temoto/vender/internal/ui/interface-text-display-ru.md

# Интерфейс клиента

Далее так описан текст на двухстрочном дисплее:
1 первая строка
2 вторая строка

### @ожидание
1 настраиваемая бегущая строка
2 (Только монеты) | (Грею воду)
- основное состояние после успешной загрузки
- key сливки/сахар -> @сливки-сахар
- key 0-9 -> @меню код напитка +key
- вставили деньги -> @меню кредит +сумма

### @меню
1 Кредит:     xxx.xx|
2 Код напитка:   xxx|
- key esc (непустой код) -> стереть последний символ
- key esc (пустой код, кредит=0) -> @ожидание
- key ok (пустой код) -> 1 ошибка 2 нет напитка
- key ok (неизвестный код) -> 1 временно 2 нет напитка
- key ok (мало денег) -> 1 Вставьте монеты(/купюры) 2 Цена xxx.xx
- key ok (достаточно денег) -> @готовится

### @сливки-сахар
1 Сливки/Сахар
2 '-' шкала '+'
- доступно всегда
- по-умолчанию 4

### @готовится
1 Готовится напиток. Подождите.
2 progress bar
- успех -> @приготовил
- ошибка -> @ошибка

### @приготовил
1 Ваш напиток ожидание
2 Спасибо
- timeout -> @ожидание

### @ошибка
1 Автомат не работает
2 (устройство) (код ошибки)
- до выключения

### @кончились-стаканы
1 Загружаются стаканы
2 Пожалуйста, подождите
- -> @ожидание / @ошибка
