temoto/vender/(threads)

Thread 1 (2018-09-10):

Hardware information

mhaqs, 2018-09-10:
I stumbled upon this repository in search of open source firmwares for vending machines. I've skimemd through the source code a bit but cannot put a finger on what hardware this firmware is for. It'd be a good addition to the repo, to have a supported hardware profile or readme that explains, how to use this.

endes123321, 2018-09-10:
Its all made in go, so I think is for a Raspberry pi or similar.

temoto, 2018-09-10:
@mhaqs we run on RaspberryPi. It could be virtually any machine supported by Go. Readme is a must, of course. I understand it's a bad reason, but didn't put much effort into documentation because it's early development stage. Hold on, I am committed to make this work publicly useful.

Dependencies:
- Linux 4.9+
- Go supported arch
- UART for MDB. We tried separate ATMega device for 9bit serial encoding, but I failed to make it reliable. With Linux kernel 4.9+ it's possible to do 9bit serial using termios.
- 4 GPIO pins for MT16S2R like display driver (as of 2018-09 in development)
- TWI (I2C) for a numpad keyboard

mhaqs, 2018-09-11:
@temoto It's good to know the project's active and you're maintaining it. May be this project could help: http://eliverse.com/wiki/index.php?title=Programming_Vendiverse_VMC_Board?

I know it differs in many respects but I've been meaning to work on a generic firmware myself. I'll go through the repo and see if I can contribute something. This is one of the primary reasons why I wanted to know the project's goal or architecture.

temoto, 2018-09-11:
@mhaqs do you know how to see their sources? I couldn't find it with a quick look.

mhaqs, 2018-09-11:
I was able to scrape the following files:

http://eliverse.com/downloads/vendiverse/software/ENV/ENV.ino
http://eliverse.com/downloads/vendiverse/software/MDB/MDB_STABLE.ino

The last one found here: http://eliverse.com/wiki/index.php?title=Vendiverse_MDB_Module

temoto, 2018-09-11:
Thank you.

mhaqs, 2018-09-17:
Just so if it helps you @temoto , I looked into the armbian image on the vendiverse website, and it has the python source code:

https://drive.google.com/file/d/1Heywm-dtGibz40IBfigaMmpYiOhnLkyE/view

temoto, 2018-09-17:
Thank you. What was interesting to me is references to hardware they used, NFC reader MFRC522 in particular.

mhaqs, 2018-09-20:
I think the differences come from using I2C as preferred communication method with the other hardware. The choice of RFC522 might also be because of that.

azonicdh2000, 2018-11-16:
@mhaqs Have you tried making the Vendiverse vmc board?

mhaqs, 2018-11-22:
@azonicdh2000 I haven't. I have instead been working on a pi3/udoo equivalent with arduinos instead. It was a bit hard to copy everything vendiverse offers.

This is why I like the approach vender takes. The vmc software should be able to cope with the hardware at offer. However, a configuration of the hardware would be great to start with. I've seen some hardware schematics posted on this repo by @AlexTransit. I will contribute some hardware and software knowledge as well in the near future.

What are you looking for @azonicdh2000? We can move the discussion else where as well.

temoto, 2018-11-22:
The key takeaway from Alex schematics is UART-MDB converter. It is optoisolated logic level 3.3-5V switch with level inverter on one line, as per MDB spec. It works, use it. Huge thanks to this person http://blog.bouni.de/2012/the-mdb-protocol-part-1.html

As of 2018-11-22 vender has (maybe alpha-beta) support for MDB coin changer and bill validator. Right now we work on drink preparing devices, and overall "kitchen" codebase, like recipes. Next step is user interface after which we'll have something to show and talk about.

azonicdh2000, 2018-11-23:
@mhaqs I’m trying to create the Vendiverse vmc board. So which part of the vendiverse was a bit hard to copy? Was it the main vmc board or tray board?

Yes maybe we should move to another discussion for vendiverse.

But I will try to look at vender.

mhaqs, 2019-02-03:
The vendiverse website is now down, but I've hosted the contents here: https://github.com/mhaqs/vendiverse. You may move this discussion over there as well.

The vendiverse project does not talk about the motor control matrix. So, to answer your question, and to help with this project, I found this:

https://github.com/CCHS-Melbourne/vend-matrix

It shows, how you can use continuous motors in a matrix and to sense a low current to finish a vend. cc @AlexTransit , if that helps.

mr-darker, 2019-02-06:
@temoto Hey I just found your project!  I'm also making open source vending software, mine is just focused on the MDB protocol specifically.  Do you have any interest in merging projects or anything like that?

My project is currently aimed to run on an ESP32 development board, but can be modified to work on most other hardware.  The end-goal is to have it run as a module on a linux operating system (once finished) as a module, so sticking as closely to C code as possible is a requirement for mine.

Anyways, if it's of interest, let me know, because that'd be pretty cool.

mr-darker, 2019-02-06:
As in it'd be cool to have some sorta help, but also cool if no help was had, and someone found it useful (it's not currently operational, but will be soon).

temoto, 2019-02-06:
@mr-darker hello mate. We just finished MDB translator device code two days ago https://github.com/temoto/vender/tree/05de26478b9932c53c0d676d7333c4d4d9286967/hardware/mega-firmware It's for ATMega328 and TWI(i2c) interface to master board (raspberrypi/orangepi in our case) but I can see how ESP family would be useful with their communication options.

I'm interested in any open vending software/hardware effort. We can start by creating Github organisation and some communication channel (not sure what is popular these days). Code merging is a good idea, let's talk details in a separate topic.

What kind of help you need?

Are you developing a vending machine?

mr-darker, 2019-02-06:
I made a [separate forum for this topic](https://github.com/mr-darker/MDB-C/issues/14).  I don't really have a communication preference.

smashah, 2019-03-11:
Hey there,

Just wonder what everyone thinks of this bit of kit:

https://www.aliexpress.com/item/Raspberry-pi-to-vending-machine-MDB-cashless-interface-adapter-board-with-housing-working-with-bill-acceptor/32883995334.html

They haven't shared any library or code with me yet. Will this repo work with this hardware?

temoto, 2019-03-12:
@smashah hello.

> Will vender work with this MDB / RS-232 adapter hardware?

Not right now. By design vender is ready for another MDB adapter. I will happily help to write required code.

I think 95$ for a simple PCB is too much. We have made custom MDB / I2C adapter exactly because alternatives have unreasonable prices. Our adapter is less than 3$ in parts, both schematic and firmware is open source here. If you are comfortable with soldering, I suggest make our adapter. I can make and send you one.

temoto, 2019-07-19:
For anyone interested, using this as public announcement channel.

Current project state is "one issue from public installation". Ingredient state is lost on power off.

Now is good time to begin integration with other hardware. Please contact me if you want to run this VMC. temotor@gmail.com

mhaqs, 2019-07-22:
@temoto I've been following this project for a while. I'd like to set up the VMC and help the project while doing so as well. I've a Raspberry Pi B+ and an Arduino Uno R3. Some other hardware that I can procure as well.

I was wondering about a plan on how to go about running the project on said hardware and have the bare minimum of MDB device and a motor control array (maybe).

shirerre, 2022-04-21:
I'm interested in this project or at least in someone helping me to develop something similar. I need a vending controller that utilize mdb can accept coins and dollars. Make change. And basically activates a relay upon correct change being presented and the relay closes when a sensor/switch is tripped. I'm trying to replicate the board utilized by the BillMate 2 attached to the old national 222 cigarette machines.

temoto, 2022-04-22:
@shirerre

> I'm interested in this project or at least in someone helping me to develop something similar. I need a vending controller that utilize mdb can accept coins and dollars. Make change. And basically activates a relay upon correct change being presented and the relay closes when a sensor/switch is tripped. I'm trying to replicate the board utilized by the BillMate 2 attached to the old national 222 cigarette machines.

If your task is really that simple to activate relay without complex scenario, telemetry, etc, probably your best option is to build atmega328p powered MDB converted and put relay activation logic directly into it. See files in hardware/schematic and hardware/mega-firmware accordingly.

This board successfully worked with ICT and JCM money hardware. Beware, it is sensitive to power noise, we didn't have enough electronic expertise to make proper filter.

WallK, 2025-04-09:
Hello! I was looking around for a way to implement optical sensor into my machine
It has the input and can, theoretically, make a refund in vend didn't happen, but only on Executive protocol, not on MDB devices (if I understood the manual correctly)
Do you think it's possible to build some kind of a MitM device that will check if optical sensor was triggered and communicate with MDB payment device? Without upsetting everything else, I mean
Or should I try to change the controller to have it all integrated?
Thanks!

temoto, 2025-04-09:
Hello.

We never worked with executive protocol.
Depending on exact coin device  you may be able to trigger refund
externally, read it's manual.

Another bad solution is half-master optical checker that will issue coin
disperse commands on stuck state. Basically ATM function. It is hacker
prone.

Central controller like in vender is definitely best option but more work.

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

WallK, 2025-04-09:
@temoto thank you for the reply
I don't have Executive devices, I know about that only from the manual

I don't have a coin dispenser too, it's all cashless. So I really need to tell POS terminal to release the sum, basically
Basically hold for vend try, charge on success, release on timeout, something like this

So is vender project alive?

temoto, 2025-04-09:
Cashless is whole different world. You have hacker safe escrow, use it if
you can.

Vender project works in real devices but Alex does development in his fork
here https://github.com/AlexTransit/vender

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

WallK, 2025-04-09:
I still need to implement the logic somewhere to instruct the POS thingy

Thanks!

AlexTransit, 2025-09-20:
> **Question:** Do you think your project would allow me to use the CC6100, which uses MDB, to communicate with a simple DIY board to achieve this?

if you do not use Bill Validator, then you can use this project.
But if you need to give back more than 127, then get the problem.

Or you can use another project.
Here is the issuance of each coin under control. And you can choose different strategies how to give out.
https://github.com/AlexTransit/vender

Adrofex, 2025-09-20:
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

Thanks so much for the quick reply!

I won't use any Bill Validator. Just coins. The most anyone should enter into the machine is 100 coins for a 100thb purchase (100x1thb coins) but I doubt anyone would take the time to do that. Most likely somewhere between 10 to 20 coins (10thb/5thb coins).

I'll give it a try and check out the other project. I'll see if I can give a link when it's done (and working, I hope!) to show it's implementation.

Thanks again!

temoto, 2025-09-20:
@Adrofex wa-di! As you can see by last commit date, this original version of vender is stalled, but @AlexTransit  continues development in his fork.

In any case vender is not super novice-friendly, for success you have to read go code. It is quite easy to add support for *any* device that works in MDB slave mode. Coin device as master (kiosk mode) is not supported here.

Your plan makes sense, it is easy to configure relatively complex scenarios via built-in script system.

Thread 2 (2019-07-22):

second hardware configuration

temoto, 2019-07-22:
> @temoto I've been following this project for a while. I'd like to set up the VMC and help the project while doing so as well. I've a Raspberry Pi B+ and an Arduino Uno R3. Some other hardware that I can procure as well.

> I was wondering about a plan on how to go about running the project on said hardware and have the bare minimum of MDB device and a motor control array (maybe).

_Originally posted by @mhaqs in https://github.com/temoto/vender/issues/1#issuecomment-513727955_

temoto, 2019-07-22:
For a plan, please:
- describe in text an end result you like to see
- list MDB devices
- specifically what motor control array, how to operate it? Datasheet?

mhaqs, 2019-07-23:
@temoto Thanks for creating a separate issues for this. I think it's better this way. I have sent you an email with my _supposed_ motor control array setup/schematic. As an end result (even if it's creating a vending machine), I'd like Vender to be able to help with the basic of operations:

- Help and control MDB devices (Cash, Coin like ICT and Cashless like Nayax)
- The MDB devices can be in master/slave set up but I'm sure that's not an issue for now.
- I've shared my humble design of a motor control array with you over email. See if it's valid at all to work with Vender.
- My design included Raspberry Pi and Arduinos for the MVP. The reason behind this was to have a modular system where I can replace Pis and Arduinos in and out as needed or upgrade them over the air in the future. But this is again a very far fetched idea.

As an MVP, if Vender can sit on my my computer and control these devices; I can use that knowledge to build more and understand the code base. I can then contribute my findings and build/contribute from there.

temoto, 2019-07-23:
Let's start with connecting Raspberry to MDB as we did. Roadmap:

- (mandatory) UART-MDB level inverter / current limiter
- one of
- - operate MDB from Raspberry (might have 5ms ACK timeout issue, may be solved with kernel tuning, I will help, but be ready that it may not be stable)
- - operate MDB via atmega-like mcu (currently works for us); be warned and ready that after uploading our firmware you may not ever use that mcu as Arduino with USB. We don't have Arduino, so I'm just warning about worst case scenario, most likely nothing irreversible happens.

Are you comfortable with installing KiCad program? Alex did all hardware schema in it and I don't know if anything else would open their files.
Please study these
- https://github.com/temoto/vender/tree/master/hardware/schematic/KiCad
- https://github.com/temoto/vender/tree/master/hardware/evend-adapter/kicad
and/or this
- http://blog.bouni.de/2012/the-mdb-protocol-part-1.html

If done properly, you should have working UART-MDB level invertor / current limiter.

At this stage I highly recommend having digital sampling oscilloscope. It feels stupid helpless to see things "just not working" when you don't know where exactly. It's possible to use Raspberry as DSO, search: [piscope] or https://abyz.me.uk/rpi/pigpio/piscope.html

temoto, 2019-07-23:
Just to make it absolutely clear, to talk MDB, you should make small hardware component which inverts UART Tx. http://blog.bouni.de/2012/mdb-levels.svg
I don't know any way around this.

Thread 3 (2019-09-20):

непрерывный reconect при недоступном брокере

AlexTransit, 2019-09-20:
при недоступном брокере, клиент постоянно пытается подключиться.
я думаю трафика будет нормально.

UPD как то странно реконектится. то пару раз в секунду, то каждуе 2-2 секунды.

AlexTransit, 2019-09-23:
на клиенте можно сделать кастомуную стратегию.
[https://www.hivemq.com/blog/hivemq-mqtt-client-features/reconnect-handling/](url)

если подключение по вафле то постоянный реконект  не парит.
если по модему, то при неуспешном подключении лучше попытаться минут через 5-10.

нужно это пока отложить.
я попробую замерить какой трафик приносит каждый реконект.

Closed 2020-05-20.

Thread 11 (2021-03-17):

ошибка при попытке размена. (vender v0.210307.0)

AlexTransit, 2021-03-17:
опустили 100 и нажали выдачу. (зажал бабло)

```
Mar 17 10:00:50.361696 vm02 vender[741]: engine.go:223: debug: engine.ExecList tag=on_front_begin list=[ evend.valve.set_temp_hot_config evend.cup.light_on ]
Mar 17 10:00:50.472117 vm02 vender[741]: state-machine.go:208: debug: ui exit FrontBegin -> FrontSelect
Mar 17 10:00:50.472117 vm02 vender[741]: state-machine.go:86: debug: ui enter FrontSelect
Mar 17 10:00:50.473758 vm02 vender[741]: accept.go:51: debug: money.accept-credit bill input disable
Mar 17 10:00:50.473758 vm02 vender[741]: accept.go:53: debug: money.accept-credit maxConfig=100 maxPrice=45 available=100 -> limit=0
Mar 17 10:00:51.447040 vm02 vender[741]: input.go:119: debug: input emit=types.InputEvent{Source:"money", Key:0x1b, Up:false}
Mar 17 10:00:51.452794 vm02 vender[741]: api.go:148: debug: money-abort cash=100
Mar 17 10:00:51.475771 vm02 vender[741]: bill.go:378: escrow result code=80
Mar 17 10:00:51.476549 vm02 vender[741]: state-machine.go:208: debug: ui exit FrontSelect -> FrontEnd
Mar 17 10:00:51.476549 vm02 vender[741]: state-machine.go:86: debug: ui enter FrontEnd
Mar 17 10:00:51.476549 vm02 vender[741]: state-machine.go:208: debug: ui exit FrontEnd -> FrontBegin
Mar 17 10:00:51.476549 vm02 vender[741]: state-machine.go:86: debug: ui enter FrontBegin
Mar 17 10:00:51.476549 vm02 vender[741]: state-machine.go:157: state=StateFrontBegin
Mar 17 10:00:51.485252 vm02 vender[741]: engine.go:223: debug: engine.ExecList tag=on_front_begin list=[ evend.valve.set_temp_hot_config evend.cup.light_on ]
Mar 17 10:00:51.535708 vm02 vender[741]: state-machine.go:208: debug: ui exit FrontBegin -> FrontSelect
Mar 17 10:00:51.535708 vm02 vender[741]: state-machine.go:86: debug: ui enter FrontSelect
Mar 17 10:00:51.537046 vm02 vender[741]: accept.go:53: debug: money.accept-credit maxConfig=100 maxPrice=45 available=0 -> limit=100

```

AlexTransit, 2021-03-27:
fix

Closed 2021-03-27.

Thread 12 (2021-04-01):

CoinCo (PAYOUT POLL)

AlexTransit, 2021-04-01:
ошибка при выдаче (застряла двушка, и заблокировала мотор выдачи 1р и 2р).

dispense.go:294: error: PLEASE REPORT PAYOUT POLL response=020407 pi={<nil> 0 Busy 0 false 0}
dispense.go:71: error: coin.give dispensed=2 < requested=3 debt=1
api.go:195: debug: money.payout coin total dispensed=7
...
dispense.go:71: error: coin.give dispensed=80 < requested=83 debt=3
api.go:195: debug: money.payout coin total dispensed=85
...
dispense.go:71: error: coin.give dispensed=0 < requested=3 debt=3
debug: money.payout coin total dispensed=5

AlexTransit, 2021-04-09:
при выдаче 28р, видимо, застряла 2р.

PLEASE REPORT PAYOUT POLL response=0b pi={<nil> 0 WasReset 0 false 0}

dispense.go:294: error: PLEASE REPORT PAYOUT POLL response=0b pi={<nil> 0 WasReset 0 false 0}
api.go:39: debug: tele.Error: PLEASE REPORT PAYOUT POLL response=0b pi={<nil> 0 WasReset 0 false 0}
api.go:189: debug: money.payout coin total dispensed=28
api.go:132: debug: money.withdraw-commit amount=2 dirty=2
потом
coin.tubestatus coinType=1 nominal=2 problem (jam/sensor/etc)

AlexTransit, 2021-05-05:
похоже это факт застревания
(наверное отключил 10 и 2 трубу)

May 04 18:00:51.779749 vm14 vender[1581]: display.line1=Spasibo
May 04 18:00:51.779749 vm14 vender[1581]: display.line2=Gotovlu
May 04 18:00:53.539846 vm14 vender[1581]: dispense.go:294: error: PLEASE REPORT PAYOUT POLL response=0b pi={<nil> 0 WasReset 0 false 0}
May 04 18:00:53.544242 vm14 vender[1581]: api.go:39: debug: tele.Error: PLEASE REPORT PAYOUT POLL response=0b pi={<nil> 0 WasReset 0 false 0}
May 04 18:00:54.233763 vm14 vender[1581]: api.go:195: debug: money.payout coin total dispensed=3
May 04 18:01:50.386101 vm14 vender[1581]: api.go:135: debug: money.withdraw-commit amount=17 dirty=17

AlexTransit, 2021-08-04:
по факту недодал 20р
May 24 11:11:17 vm02 vender[3274]: tubes before dispense (10:56,1:91,2:74,5:79,total:1194)
May 24 11:11:25 vm02 vender[3274]: dispense.go:294: error: PLEASE REPORT PAYOUT POLL response=0407 pi={Defective Sensor 0 Fatal 0 false 0}
May 24 11:11:25 vm02 vender[3274]: coin total dispensed=80
May 24 11:11:25 vm02 vender[3274]: tubes after dispense (1:91,2:74,total:239)

Closed 2021-10-08.

Thread 13 (2021-04-03):

valve poll

AlexTransit, 2021-04-03:
api.go:39: debug: tele.Error: github.com/temoto/vender/hardware/mdb/evend/generic.go:94: evend.valve(c0) POLL=30 unexpected

отдает сдачу и отключается по ошибке

temoto, 2021-04-03:
В ответе на опрос блока соленоидов неизвестный бит 0x20.

Задокументированы 0x10 льется вода и 0x40 горячая температура ушла от заданной.

30 это 10 льется вода + еще что-то.

Closed 2021-10-08.

Thread 14 (2021-04-03):

mega packet (прилетает перед отключением. видимо отрубают потребителей (изо))

AlexTransit, 2021-04-03:
прилетает перед отключением. видимо отрубают потребителей (изо)

mega-client stray packet OK clock10u=136400us,mdb_result=UART_READ_ERROR:00,mdb_duration=136280us,mdb_data= debug=440c0102354810110012353c110000

temoto, 2021-04-03:
Это шум на меге UART RX. Должен помочь RC-фильтр.

AlexTransit, 2021-05-21:
commit c2afac544652853ef6cc286406ef0dfb943cd7d8

temoto, 2021-05-21:
@AlexTransit наверное, другой комит, он бы подсветился в ссылку.

AlexTransit, 2021-05-22:
@temoto это я скопипастил из ```git log```

Closed 2021-05-21.

Thread 15 (2021-04-07):

mega ( неправильный CRC )

AlexTransit, 2021-04-07:
Apr 07 11:41:05 vm18 vender[1068]: mega.go:486: error: mega-client Parse buf=440c0102b9a210010012015e11009c000101010101010101: frame=440c0102b9a210010012015e11009c crc=9c actual=dc not
Apr 07 11:41:05 vm18 vender[1068]: io_mega.go:104: fatal: mdb.mega.Tx CRITICAL request=33: CRITICAL mega protocol error

AlexTransit, 2021-06-16:
un 16 12:12:03.875120 vm19 vender[1914]: mega.go:199: error: mega-client handshake unexpected response=OK clock10u=206390us,mdb_result=SUCCESS:00,mdb_duration=6920us,mdb_data= debug=440c0102509f1001001202b41100c4
Jun 16 12:12:03.962236 vm19 vender[1914]: Display.L1=boot v0.210604.0

mega-client Parse buf=440c0102509f1001001200b41100c4000101010101010101: frame=440c0102509f1001001200b41100c4 crc=c4 actual=cc not valid
mega-client handshake unexpected response=OK clock10u=206390us,mdb_result=SUCCESS:00,mdb_duration=6920us,mdb_data= debug=440c0102509f1001001202b41100c4

Closed 2021-10-08.

Thread 16 (2021-04-08):

cup timeout

AlexTransit, 2021-04-08:
api.go:39: debug: tele.Error: github.com/temoto/vender/hardware/mdb/device.go:246: evend.cup.dispense/wait-done/poll-loop timeout
persist.go:93: debug: persist inventory storage.write duration=36.891841ms

evend.cup.dispense/wait-done/poll-loop timeout
execute menu code=44 price=3000(raw) name='теплый шоколад со сливками и орешками': evend.cup.dispense/wait-done/poll-loop timeout
evend.cup tx request=e203 state=Error: CRITICAL code error state=invalid
broken mode

----------------------------------
Apr 15 18:55:53 vm20 vender[7304]: persist.go:93: debug: persist inventory storage.write duration=25.039037ms
Apr 15 18:55:53 vm20 vender[7304]: ui-front.go:321: debug: ui-front selected=menu code=23 price=2700(raw) name='кофе двойной со сливками и сахаром' end err=evend.cup.dispense/wait-done/poll-loop
Apr 15 18:55:53 vm20 vender[7304]: api.go:39: debug: tele.Error: github.com/temoto/vender/hardware/mdb/device.go:246: evend.cup.dispense/wait-done/poll-loop timeout
Apr 15 18:55:53 vm20 vender[7304]: github.com/temoto/vender/internal/ui/ui-front.go:329: execute menu code=23 price=2700(raw) name='кофе двойной со сливками и сахаром'
Apr 15 18:55:54 vm20 vender[7304]: engine.go:223: debug: engine.ExecList tag=on_menu_error list=[ money.abort ]
Apr 15 18:55:54 vm20 vender[7304]: api.go:148: debug: money-abort cash=27
Apr 15 18:55:57 vm20 vender[7304]: api.go:189: debug: money.payout coin total dispensed=27
Apr 15 18:55:57 vm20 vender[7304]: ui-front.go:335: on_menu_error success
Apr 15 18:55:57 vm20 vender[7304]: state-machine.go:208: debug: ui exit FrontAccept -> Broken
Apr 15 18:55:57 vm20 vender[7304]: state-machine.go:86: debug: ui enter Broken
Apr 15 18:55:57 vm20 vender[7304]: state-machine.go:114: state=broken
Apr 15 18:55:57 vm20 vender[7304]: engine.go:223: debug: engine.ExecList tag=on_broken list=[ evend.cup.light_off   evend.valve.set_temp_hot(0) ]
Apr 15 18:55:57 vm20 vender[7304]: api.go:39: debug: tele.Error: CRITICAL code error state=invalid
Apr 15 18:55:57 vm20 vender[7304]: github.com/temoto/vender/hardware/mdb/device.go:363: evend.cup tx request=e203 state=Error
Apr 15 18:55:57 vm20 vender[7304]: state-machine.go:119: error: CRITICAL code error state=invalid
Apr 15 18:55:57 vm20 vender[7304]: github.com/temoto/vender/hardware/mdb/device.go:363: evend.cup tx request=e203 state=Error
Apr 15 18:55:57 vm20 vender[7304]: github.com/temoto/vender/hardware/mdb/device.go:145: evend.cup TxMaybe request=e203 state=Error
Apr 15 18:55:57 vm20 vender[7304]: github.com/temoto/vender/internal/ui/state-machine.go:119: on_broken
Apr 15 18:55:57 vm20 vender[7304]: state-machine.go:251: debug: execute script (StateBroken)

evend.cup.dispense/wait-done/poll-loop timeout
execute menu code=23 price=2700(raw) name='кофе двойной со сливками и сахаром': evend.cup.dispense/wait-done/poll-loop timeout
evend.cup tx request=e203 state=Error: CRITICAL code error state=invalid

AlexTransit, 2021-05-11:
неправильно отрабатывает timeout (отвал по ошибке через 6.059095)

в конфиге
    cup {
      assert_busy_delay_ms = 30
      dispense_timeout_sec = 10
      ensure_timeout_sec   = 70
    }

----------------------
May 11 17:20:22.575170 vm21 vender[522]: Display.L1=спасибо
May 11 17:20:22.575170 vm21 vender[522]: Display.L2=готовлю
May 11 17:20:28.634265 vm21 vender[522]: api.go:195: debug: money.payout coin total dispensed=73
May 11 17:20:34.218113 vm21 vender[522]: api.go:39: debug: tele.Error: github.com/temoto/vender/hardware/mdb/device.go:247: evend.cup.dispense/wait-done/poll-loop timeout
May 11 17:20:34.231406 vm21 vender[522]: persist.go:93: debug: persist inventory storage.write duration=6.386331ms
May 11 17:20:34.232403 vm21 vender[522]: ui-front.go:337: debug: ui-front selected=menu code=23 price=2700(raw) name='кофе двойной со сливками и сахаром' end err=evend.cup.dispense/wait-done/poll-loop timeout
May 11 17:20:34.242911 vm21 vender[522]: Display.L1=
May 11 17:20:34.244101 vm21 vender[522]: Display.L2=ОШИБКА

AlexTransit, 2021-05-12:
fix

Closed 2021-05-12.

Thread 18 (2021-04-24):

bill ict (мотор укладчика слабо крутит. деньги не засчитывает. купюрник не принимает)

AlexTransit, 2021-04-24:
Apr 24 13:17:11.642821 vm11 vender[2109]: bill.working=false
Apr 24 13:17:13.567597 vm11 vender[2109]: escrow bill:100
Apr 24 13:17:13.567597 vm11 vender[2109]: client.working=true
Apr 24 13:17:13.572636 vm11 vender[2109]: client.working.time=24 Apr 13:17:13
Apr 24 13:17:13.572636 vm11 vender[2109]: --- client activity begin ---
Apr 24 13:17:18.937816 vm11 vender[2109]: bill.go:176: bill.poll/info: status=Info cashbox=false nominal=0 count=0 hwcode=a0 err=<nil>
Apr 24 13:17:19.152643 vm11 vender[2109]: escrow bill:100
Apr 24 13:17:19.180659 vm11 vender[2109]: stacked bill:100
Apr 24 13:17:19.392942 vm11 vender[2109]: bill.working=true

Thread 19 (2021-04-27):

hopper (неизвестный ответ)

AlexTransit, 2021-04-27:
Apr 27 15:28:50.218490 vm18 vender[2192]: generic.go:196: error: evend.hopper6.run/wait-ready PLEASE REPORT WaitReady value=20 (24&^00) -> unexpected
Apr 27 15:28:50.247742 vm18 vender[2192]: persist.go:93: debug: persist inventory storage.write duration=15.552178ms
Apr 27 15:28:50.249521 vm18 vender[2192]: ui-front.go:329: debug: ui-front selected=menu code=81 price=1800(raw) name='чай малиновый' end err=evend.hopper6.run/wait-ready/poll-loop: evend.hopp
Apr 27 15:28:50.273788 vm18 vender[2192]: display.line1=
Apr 27 15:28:50.273788 vm18 vender[2192]: display.line2=ОШИБКА
Apr 27 15:28:50.283311 vm18 vender[2192]: engine.go:223: debug: engine.ExecList tag=on_menu_error list=[ money.abort ]
Apr 27 15:28:50.284033 vm18 vender[2192]: api.go:152: debug: money-abort cash=18
Apr 27 15:28:53.736659 vm18 vender[2192]: api.go:195: debug: money.payout coin total dispensed=18
Apr 27 15:28:53.741245 vm18 vender[2192]: ui-front.go:343: on_menu_error success
Apr 27 15:28:53.741245 vm18 vender[2192]: state-machine.go:219: debug: ui exit FrontAccept -> Broken

evend.hopper6 errcode=1
evend.hopper6.run/wait-ready PLEASE REPORT WaitReady value=20 (24&^00) -> unexpected
execute menu code=81 price=1800(raw) name='чай малиновый': evend.hopper6.run/wait-ready/poll-loop: evend.hopper6(68) POLL=24 unexpected

Thread 20 (2021-04-28):

Coges  (pool timeout) непонятно выдал или нет. (проверить с выдачей большого количества)

AlexTransit, 2021-04-28:
Apr 27 15:45:00.093831 vm21 vender[24603]: Display.L1=спасибо
Apr 27 15:45:00.093831 vm21 vender[24603]: Display.L2=готовлю
Apr 27 15:45:20.353531 vm21 vender[24603]: api.go:39: debug: tele.Error: github.com/temoto/vender/hardware/mdb/device.go:247: coin.payout/poll-loop timeout
Apr 27 15:45:20.361078 vm21 vender[24603]: api.go:195: debug: money.payout coin total dispensed=0
Apr 27 15:45:20.361078 vm21 vender[24603]: api.go:104: error: money.withdraw-prepare CRITICAL change err=money.withdraw-prepare: debt=70: coin.give: coin.payout/poll-loop timeout
Apr 27 15:45:20.361078 vm21 vender[24603]: api.go:39: debug: tele.Error: money.withdraw-prepare CRITICAL change err=money.withdraw-prepare: debt=70: coin.give: coin.payout/poll-loop timeout
Apr 27 15:45:20.365095 vm21 vender[24603]: api.go:39: debug: tele.Error: github.com/temoto/vender/hardware/mdb/device.go:247: coin.payout/poll-loop timeout
Apr 27 15:45:20.365095 vm21 vender[24603]: github.com/temoto/vender/hardware/mdb/coin/dispense.go:53: coin.give
Apr 27 15:45:20.365095 vm21 vender[24603]: github.com/temoto/vender/internal/money/api.go:198: debt=70
Apr 27 15:45:20.365095 vm21 vender[24603]: github.com/temoto/vender/internal/money/api.go:103: money.withdraw-prepare
Apr 27 15:45:20.378157 vm21 vender[24603]: api.go:121: error: money.withdraw-prepare CRITICAL amount=30 dirty=100
Apr 27 15:45:20.379109 vm21 vender[24603]: api.go:39: debug: tele.Error: money.withdraw-prepare CRITICAL amount=30 dirty=100
Apr 27 15:45:57.453463 vm21 vender[24603]: api.go:135: debug: money.withdraw-commit amount=30 dirty=100

AlexTransit, 2021-08-04:
максимальная выдача 100 руб. занимает ~00:01:10
увеличение coin default timeout с 5 до 15 сек решило проблему

Closed 2021-08-04.

Thread 21 (2021-05-04):

mega protocol error (ломается когда не работает)

AlexTransit, 2021-05-04:
May 03 23:42:36.590364 vm18 vender[13240]: display.line1=Качественные напитки. Установка и обслуживание +7 963 012 9955
May 03 23:42:36.590364 vm18 vender[13240]: display.line2=
May 03 23:47:32.668812 vm18 vender[13240]: io_mega.go:104: fatal: mdb.mega.Tx CRITICAL request=33: CRITICAL mega protocol error
May 03 23:47:32.754459 vm18 systemd[1]: vender.service: Main process exited, code=exited, status=1/FAILURE
May 03 23:47:32.789618 vm18 bash[6978]: + [[ exit-code != success ]]
May 03 23:47:32.793797 vm18 bash[6978]: + /bin/systemctl start vender-broken.service
May 03 23:47:32.863934 vm18 systemd[1]: Starting Vender daemon fail mode...

AlexTransit, 2021-06-03:
Jun 02 10:56:51.028978 vm19 vender[26650]: mega.go:486: error: mega-client Parse buf=440c01020cdd10010012015e1100bc000101010103010101: frame=440c01020cdd10010012015e1100bc000101010103
Jun 02 10:56:51.037911 vm19 vender[26650]: io_mega.go:104: fatal: mdb.mega.Tx CRITICAL request=d3: CRITICAL mega protocol error

mega-client handshake unexpected response=OK clock10u=32930us,mdb_result=SUCCESS:00,mdb_duration=3500us,mdb_data= debug=440c01020cdd10010012015e1100bc
critical daemon broken mode

Closed 2021-10-08.

Thread 22 (2021-05-12):

mega (UART_READ_UNEXPECTED)

AlexTransit, 2021-05-12:
May 12 10:55:48.304452 vm16 vender[4457]: Display.L1=спасибо
May 12 10:55:48.304452 vm16 vender[4457]: Display.L2=готовлю
May 12 10:55:55.905914 vm16 vender[4457]: api.go:195: debug: money.payout coin total dispensed=83
May 12 10:56:33.291880 vm16 vender[4457]: mega.go:242: mega-client stray UART_READ_UNEXPECTED likely caused by electrical noise, add filter packet=OK clock10u=548240us,mdb_result=UART_READ_UNEXPECTED:0d,mdb_duration=547850us,mdb_data= debug=440c0102d62810100d12d601110000
May 12 10:56:33.342068 vm16 vender[4457]: persist.go:93: debug: persist inventory storage.write duration=28.332238ms
May 12 10:56:33.342973 vm16 vender[4457]: ui-front.go:354: debug: ui-front selected=menu code=6 price=1700(raw) name='кофе со сливками и сахаром' end err=evend.mixer.move:61->57/wait-done/poll-loop: evend.mixer(c8) POLL=050b unexpected
May 12 10:56:33.380893 vm16 vender[4457]: Display.L1=
May 12 10:56:33.380893 vm16 vender[4457]: Display.L2=ОШИБКА

Closed 2021-10-08.

Thread 23 (2021-05-24):

CoinCo (PAYOUT POLL response=0407)

AlexTransit, 2021-05-24:
по факту недодал 20р
May 24 11:11:17 vm02 vender[3274]: tubes before dispense (10:56,1:91,2:74,5:79,total:1194)
May 24 11:11:25 vm02 vender[3274]: dispense.go:294: error: PLEASE REPORT PAYOUT POLL response=0407 pi={Defective Sensor 0 Fatal 0 false 0}
May 24 11:11:25 vm02 vender[3274]: coin total dispensed=80
May 24 11:11:25 vm02 vender[3274]: tubes after dispense  (1:91,2:74,total:239)

AlexTransit, 2021-08-04:
обьеденил со схожей проблемой

Closed 2021-08-04.

Thread 24 (2021-06-25):

bill ICT. 2 escrow + stacked = 0 (написал кредит до укладки)

AlexTransit, 2021-06-25:
Jun 25 15:25:35.865929 vm05 vender[681]: escrow bill:50
Jun 25 15:25:35.865929 vm05 vender[681]: --- client activity begin ---
Jun 25 15:25:35.865929 vm05 vender[681]: transport-mqtt.go:108: transport sendstate payload=07
Jun 25 15:25:35.908745 vm05 vender[681]: Display.L1=Кредит: 50
Jun 25 15:25:35.908745 vm05 vender[681]: Display.L2=Код:
Jun 25 15:25:42.965780 vm05 vender[681]: bill.go:173: bill.poll/info: status=Info cashbox=false nominal=0 count=0 hwcode=a0 err=<nil>
Jun 25 15:25:43.180963 vm05 vender[681]: escrow bill:50
Jun 25 15:25:43.222062 vm05 vender[681]: stacked bill:50
Jun 25 15:26:09.754475 vm05 vender[681]: key.sugar+
Jun 25 15:26:09.761633 vm05 vender[681]: input.go:121: debug: input emit=types.InputEvent{Source:"evend-keyboard", Key:0x44, Up:false}
Jun 25 15:26:10.143006 vm05 vender[681]: key.sugar+
Jun 25 15:26:10.143006 vm05 vender[681]: input.go:121: debug: input emit=types.InputEvent{Source:"evend-keyboard", Key:0x44, Up:false}
Jun 25 15:26:10.530223 vm05 vender[681]: input.go:121: debug: input emit=types.InputEvent{Source:"evend-keyboard", Key:0x44, Up:false}
Jun 25 15:26:10.531088 vm05 vender[681]: key.sugar+
Jun 25 15:26:11.126528 vm05 vender[681]: input.go:121: debug: input emit=types.InputEvent{Source:"evend-keyboard", Key:0x44, Up:false}
Jun 25 15:26:11.126528 vm05 vender[681]: key.sugar+
Jun 25 15:26:13.316275 vm05 vender[681]: input.go:121: debug: input emit=types.InputEvent{Source:"evend-keyboard", Key:0x43, Up:false}
Jun 25 15:26:13.316275 vm05 vender[681]: key.sugar-
Jun 25 15:26:13.589181 vm05 vender[681]: input.go:121: debug: input emit=types.InputEvent{Source:"evend-keyboard", Key:0x43, Up:false}
Jun 25 15:26:13.589181 vm05 vender[681]: key.sugar-
Jun 25 15:26:14.392501 vm05 vender[681]: input.go:121: debug: input emit=types.InputEvent{Source:"evend-keyboard", Key:0x42, Up:false}
Jun 25 15:26:14.392501 vm05 vender[681]: key.cream+
Jun 25 15:26:14.632502 vm05 vender[681]: input.go:121: debug: input emit=types.InputEvent{Source:"evend-keyboard", Key:0x42, Up:false}
Jun 25 15:26:14.633369 vm05 vender[681]: key.cream+
Jun 25 15:26:15.555085 vm05 vender[681]: input.go:121: debug: input emit=types.InputEvent{Source:"evend-keyboard", Key:0x41, Up:false}
Jun 25 15:26:15.555085 vm05 vender[681]: key.cream-
Jun 25 15:26:18.631759 vm05 vender[681]: Display.L1=Качественные напитки. Установка и обслуживание +7 963 012 9955
Jun 25 15:26:18.631759 vm05 vender[681]: Display.L2=
Jun 25 15:26:23.121099 vm05 vender[681]: input.go:121: debug: input emit=types.InputEvent{Source:"evend-keyboard", Key:0x31, Up:false}
Jun 25 15:26:23.162633 vm05 vender[681]: Display.L1=Кредит: 0
Jun 25 15:26:23.162633 vm05 vender[681]: Display.L2=Код: 1

AlexTransit, 2021-06-25:
как должно быть.

0.774671 : escrow bill:50
0.774671 : --- client activity begin ---
0.783342 : transport-mqtt.go:108: transport sendstate payload=07
0.809566 : Display.L1=Credit: 50
0.809566 : Display.L2=Code:
0.874647 : stacked bill:50
0.879029 : accept.go:88: debug: money.bill credit amount=50 bill=50 cash=0 total=0

Thread 26 (2021-07-01):

espresso (POLL=70 unexpected)

AlexTransit, 2021-07-01:
Jul 01 12:46:52.525770 vm04 vender[1635]: api.go:38: debug: tele.Error: github.com/temoto/vender/hardware/mdb/evend/generic.go:94: evend.espresso(e8) POLL=70 unexpected
Jul 01 12:46:52.525770 vm04 vender[1635]: github.com/temoto/vender/hardware/mdb/device.go:236: evend.espresso.grind/wait-done/poll-loop

execute menu code=18 price=2400(raw) name='зерновой американо со сливками и сахаром': evend.espresso.grind/wait-done/poll-loop: evend.espresso(e8) POLL=70 unexpected

Closed 2021-10-08.

Thread 27 (2021-07-08):

hopper poll err

AlexTransit, 2021-07-08:
Jul 07 17:59:27 vm06 vender[5071]: generic.go:196: error: evend.hopper5.run/wait-ready PLEASE REPORT WaitReady value=20 (24&^00) -> unexpected
Jul 07 17:59:27 vm06 vender[5071]: api.go:38: debug: tele.Error: evend.hopper5.run/wait-ready PLEASE REPORT WaitReady value=20 (24&^00) -> unexpected
Jul 07 17:59:27 vm06 vender[5071]: api.go:38: debug: tele.Error: github.com/temoto/vender/hardware/mdb/evend/generic.go:94: evend.hopper5(60) POLL=24 unexpected
Jul 07 17:59:27 vm06 vender[5071]: github.com/temoto/vender/hardware/mdb/device.go:236: evend.hopper5.run/wait-ready/poll-loop

Thread 28 (2021-07-10):

mega (padding=not valid)

AlexTransit, 2021-07-10:
io_mega.go:109: error: mdb.mega.Tx request=33: command=440208331a: frame=040000000001fe343b2405fdfdfdfdfdfdfdfdfdfdfdfd padding=fdfdfdfd not valid

mdb.mega.Tx request=33: command=440208331a: frame=040000000001fe343b2405fdfdfdfdfdfdfdfdfdfdfdfd padding=fdfdfdfd not valid
bill tx request=33 state=Online: mdb.Tx send=33 recv=: mdb.mega.Tx request=33: command=440208331a: frame=040000000001fe343b2405fdfdfdfdfdfdfdfdfdfdfdfd padding=fdfdfdfd not valid

Thread 29 (2021-08-04):

error spam

AlexTransit, 2021-08-04:
**при выдаче**
execute menu code=6 price=1700(raw) name='кофе со сливками и сахаром': evend.elevator.move:0->100/wait-done/poll-loop: evend.elevator.move:0->100/wait-done: evend.elevator is offline

**далее в цикле непрерывно начал слать.**
probe device=bill required=false: bill.init: bill RESET: bill is offline
probe device=coin required=true: coin.init: coin RESET: coin is offline
probe device=evend.cup required=true: evend.cup.init: evend.cup(e0).initIO: evend.cup RESET: evend.cup is offline
probe device=evend.hopper2 required=false: evend.hopper2.init: evend.hopper2(48).initIO: evend.hopper2 RESET: evend.hopper2 is offline
probe device=evend.conveyor required=true: evend.conveyor.init: evend.conveyor(d8).initIO: evend.conveyor RESET: evend.conveyor is offline
probe device=evend.hopper7 required=false: evend.hopper7.init: evend.hopper7(70).initIO: evend.hopper7 RESET: evend.hopper7 is offline
probe device=evend.valve required=true: evend.valve.init: evend.valve(c0).initIO: evend.valve RESET: evend.valve is offline
probe device=evend.hopper8 required=false: evend.hopper8.init: evend.hopper8(78).initIO: evend.hopper8 RESET: evend.hopper8 is offline
probe device=evend.hopper3 required=false: evend.hopper3.init: evend.hopper3(50).initIO: evend.hopper3 RESET: evend.hopper3 is offline
probe device=evend.hopper5 required=false: evend.hopper5.init: evend.hopper5(60).initIO: evend.hopper5 RESET: evend.hopper5 is offline
probe device=evend.hopper4 required=false: evend.hopper4.init: evend.hopper4(58).initIO: evend.hopper4 RESET: evend.hopper4 is offline
probe device=evend.hopper1 required=false: evend.hopper1.init: evend.hopper1(40).initIO: evend.hopper1 RESET: evend.hopper1 is offline
probe device=evend.hopper6 required=false: evend.hopper6.init: evend.hopper6(68).initIO: evend.hopper6 RESET: evend.hopper6 is offline
probe device=evend.elevator required=true: evend.elevator.init: evend.elevator(d0).initIO: evend.elevator RESET: evend.elevator is offline
probe device=evend.mixer required=true: evend.mixer.init: evend.mixer(c8).initIO: evend.mixer RESET: evend.mixer is offline
probe device=evend.mixer required=true: evend.mixer.init: evend.mixer(c8).initIO: evend.mixer RESET: evend.mixer is offline
"hardware enum: multiple errors:
- MDB timeout
github.com/temoto/vender/hardware/mdb/mdb.go:73: mdb.Tx send=08 recv=
github.com/temoto/vender/hardware/mdb/device.go:361: coin is offline
github.com/temoto/vender/hardware/mdb/device.go:296: coin RESET
github.com/temoto/vender/hardware/mdb/coin/coin.go:100: coin.init
github.com/temoto/vender/internal/state/hardware.go:263: probe device=coin required=true
- multiple errors:
- MDB timeout
github.com/temoto/vender/hardware/mdb/mdb.go:73: mdb.Tx send=e0 recv=
github.com/temoto/vender/hardware/mdb/device.go:361: evend.cup is offline
github.com/temoto/vender/hardware/mdb/device.go:296: evend.cup RESET
github.com/temoto/vender/hardware/mdb/evend/generic.go:82: evend.cup(e0).initIO
github.com/temoto/vender/hardware/mdb/evend/cup.go:39: evend.cup.init
github.com/temoto/vender/internal/state/hardware.go:263: probe device=evend.cup required=true
- MDB timeout
github.com/temoto/vender/hardware/mdb/mdb.go:73: mdb.Tx send=d8 recv=
github.com/temoto/vender/hardware/mdb/device.go:361: evend.conveyor is offline
github.com/temoto/vender/hardware/mdb/device.go:296: evend.conveyor RESET
github.com/temoto/vender/hardware/mdb/evend/generic.go:82: evend.conveyor(d8).initIO
github.com/temoto/vender/hardware/mdb/evend/conveyor.go:66: evend.conveyor.init
github.com/temoto/vender/internal/state/hardware.go:263: probe device=evend.conveyor required=true
- MDB timeout
github.com/temoto/vender/hardware/mdb/mdb.go:73: mdb.Tx send=c0 recv=
github.com/temoto/vender/hardware/mdb/device.go:361: evend.valve is offline
github.com/temoto/vender/hardware/mdb/device.go:296: evend.valve RESET
github.com/temoto/vender/hardware/mdb/evend/generic.go:82: evend.valve(c0).initIO
github.com/temoto/vender/hardware/mdb/evend/valve.go:103: evend.valve.init
github.com/temoto/vender/internal/state/hardware.go:263: probe device=evend.valve required=true
- MDB timeout
github.com/temoto/vender/hardware/mdb/mdb.go:73: mdb.Tx send=d0 recv=
github.com/temoto/vender/hardware/mdb/device.go:361: evend.elevator is offline
github.com/temoto/vender/hardware/mdb/device.go:296: evend.elevator RESET
github.com/temoto/vender/hardware/mdb/evend/generic.go:82: evend.elevator(d0).initIO
github.com/temoto/vender/hardware/mdb/evend/elevator.go:47: evend.elevator.init
github.com/temoto/vender/internal/state/hardware.go:263: probe device=evend.elevator required=true
- MDB timeout
github.com/temoto/vender/hardware/mdb/mdb.go:73: mdb.Tx send=c8 recv=
github.com/temoto/vender/hardware/mdb/device.go:361: evend.mixer is offline
github.com/temoto/vender/hardware/mdb/device.go:296: evend.mixer RESET
github.com/temoto/vender/hardware/mdb/evend/generic.go:82: evend.mixer(c8).initIO
github.com/temoto/vender/hardware/mdb/evend/mixer.go:64: evend.mixer.init
github.com/temoto/vender/internal/state/hardware.go:263: probe device=evend.mixer required=true"

...
