temoto/vender/(list of files, drawings)

Other design files:
hardware/schematic/KiCad/NewMain1.dsn
hardware/schematic/KiCad/NewMain2.dsn
hardware/schematic/KiCad/NewMain.dsn
