temoto/vender/(commit log)

2016-02-01 proper PINB5, no LED
2016-02-05 TWI idle state, reset command, keyboard works
    [main.c]
2016-02-11 avr-uart: volatile, inline attributes
2016-02-11 head: initial version of i2c talk to avr
2016-02-22 avr-mdb sporadic reset bug
    [main.c]
2016-02-22 avr software crash (stack?), more logs, REPL
    [buffer.c, main.c]
2016-02-27 reset mdb_in buffer along with state=idle
    [main.c]
2016-03-01 fix bug (send ack after package)
    [main.c]
2016-03-01 reset timer on each RX byte
    [main.c]
2018-06-22 drop avr-uart translator; linux 4.9+ allows 9bit via CMSPAR
2018-08-18 incapsulate device specific MDB code hardware/mdb/{bill,coin,...}
2018-10-06 config: uart_driver was ignored because unexported field
2018-10-09 coin: log,store routing, log {Tube,Diag}Status, stringer trimprefix
    Lessons learned:
    - Dispense command will report false success when requested coins are absent
    - Deposit and Dispense may report false success under hardware failures
    - must use TubeStatus and DiagStatus to confirm money changed hands
    - wait poll=not-busy before dispense *and* before tubestatus
    This is intermediate work saving where {tube,diag}status is only logged.
2018-10-10 mix see list below
    - Dispense choose only routed coin types; TODO roundrobin if multiple
    - Diag PoweringUp,Inhibited is also OK
    - Diag tests
    - CommandPoll,Diag take result pointer arg - step to less allocations
    - rename mdb.NewTestMDB{,Raw} will be used for low level parsing tests
    only
    - `mdb.NewTestMDBChan` use for high-level tests operating with valid
    `Packet`
    - coin Poll tests use NewTestMDBChan
    - use `testing.TB` interface instead of *T,*B where possible
    - cosmetic
2018-10-10 mdb: Packet.Wire(ffDance=true) did not encode ff as ffff in body
2018-10-12 mdb: drop fast uarter, Tx() is part of Uarter now
    There was better version of io_fast that was never commited.
    - somehow stdlib+bufio is faster than syscall+my buffer
    Next attempt to speed mdb is write Uarter.Tx in C and Rust.
    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
2018-10-29 add KiCad schematic
    [NewMain.dsn, NewMain.kicad_pcb, NewMain.sch, NewMain1.dsn, NewMain2.dsn]
2018-11-23 kitchen devices initial support + many related
2018-11-24 correct transmit current 100ma
    [NewMain.sch]
2019-01-30 Restore hardware MDB translator
    Reasons:
    - failed to make Linux tty with low latency - 4ms delay to ACK is too
    close to 5ms limit per MDB spec
    - had reproducible cases where Linux tty with CMSPAR does not set 9th bit properly
    - iodin (bit-banging UART with pigpio) works, ACK delay is 2.3-3ms -
    works, use it in absense of hardware MDB module
    - hardware MDB module makes 23us delay to ACK - nice, right?
    - hardware module also works as TWI slave for vending keyboard
    [buffer.c, crc.c, crc.h, crc_test.c, main.c, mdb.c]
2019-01-31 mega-gate v0.2 stable, notify pin, watchdog
2019-02-05 mega-gate v1.2 protocol rewrite, source rename, 16bit timer
2019-02-05 mega uarter available in core cmd/vender app
2019-02-07 mdb mega uarter proper response-error wrapping
2019-02-08 WIP Doer for existing MDB devices - not finished
2019-02-12 hide Mdber from devices into context, bill/coin use generic Reset/Setup/Poll implementation
2019-02-14 single POLL loop implementation without channel, removed PollResult, per-device Delay{Next,Err,Idle}
2019-02-21 user-defined action execution engine
    - executing cyclic graphs is hard
    - we only really need a DSL for recipes and it seems very doable with
    current do.Transaction restrictions; Turing complete scripting language
    slows development of what is more important at this time
    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
2019-02-21 mdb: PollLoopActive to wait for action completed
    - ReadyChan -> PollUntilEmpty
    - evend {Device,}Generic rename, struct embedding
2019-02-25 more evend drivers implemented (not complete)
2019-02-28 mega: i2c interface file -> ioctl(I2C_RDWR), start rewrite mega protocol to more stupid and reliable
2019-03-12 making head-mega protocol more reliable
    - 1 request packet, 1 response packet per transmission
    - don't accept new request before response is consumed
    - UART ignore reads out of session
    - more accurate MDB timer
    - few response headers: OK,ERROR,RESET
    RESET is only sent on boot
    - errors sent as FIELD_ERROR{2,N} (may repeat)
    - MDB result in RESPONSE_OK as field
    - TWI listen (keyboard) data in RESPONSE_OK as field
    [bit.h, buffer.c, buffer.h, common.h, config.h, crc.h, main.c, mdb.c]
2019-03-12 script parsing TWI (I2C) sessions from digital scope
2019-03-12 evend doc protocol types, important device notes, some error codes, some translation
2019-03-14 mega workaround Raspberry I2C first bit corruption, COMMAND_TWI_LISTEN, handle NAK before send complete, debug buffer
    [common.h, config.h, main.c, mdb.c, protocol.h]
2019-03-14 kitchen -> scenarios part1
    Plan:
    - make devices register their actions in Engine, like evend.Enum()
    - drop kitchen subsystem idea
    - VMC runs scenarios
2019-03-14 evend up
    - conveyor @move_mixer (position 1)
    - conveyor MoveSync pick timeout based on distance to travel
    - mixer {Move,Shake}Sync
2019-03-18 mega: use ready pin, push TWI listen data at first chance
2019-03-25 MDB adapter v2.0 over SPI
    When VMC and keyboard (also I2C master) were talking to mega
    simultaneously, mega (or keyboard) would go crazy, respond as random
    slave addresses (as shown by i2cdetect) then stop responding at all.
    Most likely it was caused by incorrect handling of TW_STATUS in my mega
    firmware. Wasted two days of random changes without stable solution.
    So we decided to rewrite everything to SPI, primarily because it's a
    separate (even electrically) bus. Had we got ATMega328PB on hands or
    similar device with more peripherals, I would choose UART for VMC-mega
    communication.
    Current implementation of SPI handler on mega is blocking other
    interrupts for longer than required. This ca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
2019-04-09 prototype money/UI together
2019-04-10 mdb.evend.valve_get_temp_hot: save response temp
2019-04-15 engine: Seq is common special case of Tree
2019-06-10 use /dev/gpiochip for LCD display and mega notify pin
2019-06-10 pre release pcb
2019-06-14 pcb release v1.0
    [evend-adapter.kicad_pcb, evend-adapter.sch]
2019-06-14 remove footprint
2019-06-14 pcb 1.0.0
    [evend-adapter.kicad_pcb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]
2019-06-24 gitignore kicad __previews/ dir
2019-07-01 KISS UI switcher, uifront broken state, uifront overlap fixed, ui/vmc common code extracted
2019-07-04 mdb.bill: RESET device on start, fixed double Lock() typo, fixed Escrow poll, try using escrow
2019-07-06 evend: mixer currentPos, valve inform hot temp
2019-07-07 cache hot water temperature sensor data
2019-07-07 evend conveyor WaitReady irritating POLL=04 (miss) delays fixed with Device.Keepalive() continous background poll
2019-07-11 check hot water temperature
2019-07-15 mega: continous twi_listen packets prevented mdb response
    Failed to identify root cause. Side-fixed with:
    - twi_step will only write response if mdb is in idle state
    - successful mdb response will also ship any outgoing twi_data
    Important takeaway for mega-client: expect TWI_DATA field in any
    response.
    Buzzword: priority inversion
    [common.h, config.h, main.c, mdb.c, twi.c]
2019-07-17 service menu switch crutch
2019-07-25 evend: add 2x delay _before_ evend devices RESET
2019-07-28 service menu enter/exit hooks
    Used to turn off water heater during coffee machine servicing.
2019-07-28 mdb: Keepalive infinitely retries RESET per MDB spec
    - mdb.Device.LastOk 0 only at init, monotonic
    - mdb.Device.DoInit preparation for lazy init
    - separate ErrOffline
    - ErrTimeout is not constructed by Timeoutf, check with
    `Cause(err)==mdb.ErrTimeout`
2019-08-17 hardware: valve get_hot_temp=0 is important sensor problem
2019-08-17 ui: no active menu items switches to StateBroken
2019-08-21 on_front_begin, on_broken; ui.Event; tele.{Broken/Service -> State}
    - fixed money event freeze on ui.showError/ConveyText
    - generic mechanism to ingest/mock input/money/timeout events
    - single place to define service button
    - XXX FIXME hot water is critical error TODO configurable error severity
    - XXX any error during menu exec leads to StateBroken; TODO configurable
    error severity
2019-08-23 money abort button goes to StateFrontEnd to reset UI
    - coin return request injected as input event
    - ui-front KeyReject at empty code is ignored (was StateFrontEnd)
2019-09-03 config SPI speed
2019-09-10 tele: command lock UI, implied by command exec
    This is to clearly communicate with end users that machine is currently performing remotely controlled operation.
    Some UI states (such as FrontAccept, all service states) take priority over UI lock, so it will not interrupt important user action.
2019-10-07 mdb: device state, bus.Error->telemetry, split client package
2019-10-11 hardware: mdb device state v2 + tests (finally)
2019-10-15 tele: report cashbox/tubes
    - tele inventory value as float
2019-10-30 hardware: common embedded mdb.Device
2019-11-02 hardware: mdb.evend.conveyor_shake(?)
2019-11-07 hardware: mdb device state v2 deadlock in evend error code retrieval
2019-11-17 hardware: devices must be listed in config to use
    - device "name" { required=true } makes boot fail on *any* error during that device init
2019-11-19 bug-fix multiplay intterupt fix compile in AtmelStudio version 0203
    [config.h, main.c]
2019-11-30 hardware: some Coges coin device requires delay after PAYOUT command
2019-12-16 hardware/mega-client: ignore stray UART_READ_UNEXPECTED
    and more readable protocol parse test
2019-12-20 hardware: mdb.coin TubeStatus operates virtual coin types, not physical tubes
2020-02-04 hardware: plug-and-play
    Register device actions before their init operations.
    Allows to boot vender without all hardware and add devices live.
    Downside: engine-cli is polluted with all drivers' actions.
2020-02-04 custom temperature logic caused broken mode when valve device was optional and offline
2020-02-16 hardware: evend.elevator skip calibration for pos 0/100
2020-03-01 tele command show_QR
    Currently for Russian electronic tax verification.
    May be used for authentication or payment.
2020-03-20 (ACTION REQUIRED) on_boot will not stop on errors caused by offline optional devices + mdb. prefix is gone from all device names and engine actions
    - evend device actions now consistently named "evend.{device}.action"
    - some MDB logs had incosistent device names such as mdb.elevator -> evend.elevator or mdb.mdb.bill -> bill
    - one small step closer to uniform support of devices on other buses (not MDB)
2020-05-21 add speed command to conveyor
2020-05-22 fix evend.conveyor test
2020-06-23 hardware: add step logging (elevator and conveyor)
